Yitaek/2DUltrasound/README.md

# 2DUltrasound
Final Project for BME 464
